Senft5/MOSSE/README.md

# MOSSE
A modular audio system for making and consuming audio content on the go.
The device functions like an iPod, with a capactive touch clickwheel, as well as a capactive touch slider for tweaking parameters.
Music files will be able to be uploaded over the usb-c port.
I made this project because I wanted something to take with me on the go that was highgly capable of all things audio. I want to be able to record, produce, and play back any audio that I can imagine, and this is the first step on that journey.


|No.|Quantity|Comment |Designator |Footprint |Value |Manufacturer Part |Manufacturer |Supplier Part|Supplier|LCSC Stock|LCSC Price|JLCPCB Stock|JLCPCB Price|Link |
|---|---|---|---|---|---|---|---|---|---|---|---|---|---|---|
|1  |1 |4.7uF |C1 |C0603 |4.7uF |TCC0603X7R475K160CT |CCTC(三环) |C48543608 |LCSC | | |9728 |0.0011 |https://www.lcsc.com/product-detail/C48543608.html|
|2  |3 |10uF |C2,C3,C7 |C0603 |10uF  |0603X106K100CT |Walsin(华新科) |C2840513 |LCSC | | |1835 |0.0022 |https://www.lcsc.com/product-detail/C2840513.html |
|3  |1 |100nF |C11 |C0603 |100nF |CC0603KRX7R9BB104 |YAGEO(国巨) |C14663 |LCSC | | |38654695 |0.0004 |https://www.lcsc.com/product-detail/C14663.html |
|4  |1 |1uF |C12 |C0603 |1uF |CL10A105KB8NNNC |SAMSUNG(三星) |C15849 |LCSC | | |8136262 |0.0012 |https://www.lcsc.com/product-detail/C15849.html |
|5  |2 |2.2uF |C13,C15 |C0603 |2.2uF |CL10A225KO8NNNC |SAMSUNG(三星) |C23630 |LCSC | | |4831225 |0.001 |https://www.lcsc.com/product-detail/C23630.html |
|6  |2 |4.7uF |C14,C16 |C0603 |4.7uF |V475K0603X5R160NDT |VIIYONG(微容) |C2980396 |LCSC | | |520 |0.0022 |https://www.lcsc.com/product-detail/C2980396.html |
|7  |2 |2.2uF |C17,C18 |C0603 |2.2uF |0603X225M160NT |FH(风华) |C50331154 |LCSC | | |10937 |0.001 |https://www.lcsc.com/product-detail/C50331154.html|
|8  |1 |1uF |C19 |C0603 |1uF |HCH0603B105K050T |IHHEC(禾伸堂) |C915830 |LCSC | | |3529 |0.0039 |https://www.lcsc.com/product-detail/C915830.html  |
|9  |3 |22uF |C20,C21,C22 |C0805 |22uF  |0805X226M160NT |FH(风华) |C129302 |LCSC | | |148576 |0.0043 |https://www.lcsc.com/product-detail/C129302.html  |
|10 |8 |10uF |C23,C24,C25,C26,C27,C28,C30,C33 |C0805 |10uF  |0805B106K160NT |FH(风华) |C92341 |LCSC | | |303267 |0.0043 |https://www.lcsc.com/product-detail/C92341.html |
|11 |1 |10pF |C29 |C0603 |10pF  |0603N100D500CT |Walsin(华新科) |C296044 |LCSC | | |8048 |0.0007 |https://www.lcsc.com/product-detail/C296044.html  |
|12 |4 |100nF |C31,C32,C34,C35 |C0603 |100nF |CL10B104KB8NNNC |SAMSUNG(三星) |C1591 |LCSC | | |8828921 |0.0005 |https://www.lcsc.com/product-detail/C1591.html |
|13 |1 |TF PUSH |CARD1 |TF-SMD_TF-PUSH | |TF PUSH |SHOU HAN(首韩) |C393941 |LCSC | | |148388 |0.0095 |https://www.lcsc.com/product-detail/C393941.html  |
|14 |1 |B3B-PH-K-S(LF)(SN) |CN1 |CONN-TH_B3B-PH-K-S | |B3B-PH-K-S(LF)(SN) |JST |C131339 |LCSC | | |186414 |0.0064 |https://www.lcsc.com/product-detail/C131339.html  |
|15 |1 |B2B-PH-K-S(LF)(SN) |CN2 |CONN-TH_B2B-PH-K-S | |B2B-PH-K-S(LF)(SN) |JST |C131337 |LCSC | | |229418 |0.0046 |https://www.lcsc.com/product-detail/C131337.html  |
|16 |1 |KH-FG0.5-H2.0-50PIN  |CN3 |FPC-SMD_KH-FG0.5-H2.0-50PIN | |KH-FG0.5-H2.0-50PIN |kinghelm(金航标)  |C2797221 |LCSC | | |1442 |0.0303 |https://www.lcsc.com/product-detail/C2797221.html |
|17 |1 |PJ-320D |CN4 |AUDIO-SMD_PJ-320D-1 | |PJ-320D |SHOU HAN(首韩) |C431535 |LCSC | | |96666 |0.0077 |https://www.lcsc.com/product-detail/C431535.html  |
|18 |1 |1N4148WS |D2 |SOD-323_L1.8-W1.3-LS2.5-RD | |1N4148WS |CJ(江苏长电/长晶) |C2128 |LCSC | | |4360704 |0.0014 |https://www.lcsc.com/product-detail/C2128.html |
|19 |1 |FH34SRJ-22S-0.5SH(50)|FPC1 |FFC-SMD_22P-P0.50_HRS_FH34SRJ-22S-0.5SH| |FH34SRJ-22S-0.5SH(50)  |HRS(广濑) |C2889325 |LCSC | | |8830 |0.0517 |https://www.lcsc.com/product-detail/C2889325.html |
|20 |1 |FH34SRJ-10S-0.5SH(50)|FPC2 |FFC-SMD_10P-P0.50_FH34SRJ-10S-0.5SH | |FH34SRJ-10S-0.5SH(50)  |HRS(广濑) |C324723 |LCSC | | |31597 |0.0324 |https://www.lcsc.com/product-detail/C324723.html  |
|21 |1 |1.5uH |L2 |IND-SMD_CYA1040-100UH |1.5uH |CYA1040-1.5UH |SHOU HAN(首韩) |C6364672 |LCSC | | |325 |0.05 |https://www.lcsc.com/product-detail/C6364672.html |
|22 |3 |MPZ1608S102ATA00 |L3,L4,L5 |L0603 | |MPZ1608S102ATA00 |TDK |C76814 |LCSC | | |279006 |0.002 |https://www.lcsc.com/product-detail/C76814.html |
|23 |1 |AO3400A |Q1 |SOT-23-3_L3.0-W1.6-P1.90-LS2.8-BR | |AO3400A |ElecSuper(静芯)  |C5224194 |LCSC | | |103382 |0.0036 |https://www.lcsc.com/product-detail/C5224194.html |
|24 |1 |1kΩ |R1 |R0603 |1kΩ |0603WAF1001T5E |UNI-ROYAL(厚声)  |C21190 |LCSC | | |44377889 |0.0003 |https://www.lcsc.com/product-detail/C21190.html |
|25 |1 |1.13kΩ |R2 |R0603 |1.13kΩ|0603WAF1131T5E |UNI-ROYAL(厚声)  |C22833 |LCSC | | |95366 |0.0002 |https://www.lcsc.com/product-detail/C22833.html |
|26 |1 |47kΩ |R3 |R0603 |47kΩ  |SCR0603J47K |VO(翔胜) |C3017699 |LCSC | | |2661 |0.0002 |https://www.lcsc.com/product-detail/C3017699.html |
|27 |1 |220kΩ |R10 |R0603 |220kΩ |0603WAF2203T5E |UNI-ROYAL(厚声)  |C22961 |LCSC | | |209466 |0.0003 |https://www.lcsc.com/product-detail/C22961.html |
|28 |1 |10kΩ |R11 |R0603 |10kΩ  |0603WAF1002T5E |UNI-ROYAL(厚声)  |C25804 |LCSC | | |19721756 |0.0002 |https://www.lcsc.com/product-detail/C25804.html |
|29 |1 |274kΩ |R12 |R0603 |274kΩ |RT0603BRE07274KL |YAGEO(国巨) |C705837 |LCSC | | |2189 |0.0041 |https://www.lcsc.com/product-detail/C705837.html  |
|30 |2 |100kΩ |R13,R15 |R0603 |100kΩ |FCR0603F100K |VO(翔胜) |C5913165 |LCSC | | |4019 |0.0003 |https://www.lcsc.com/product-detail/C5913165.html |
|31 |1 |270kΩ |R14 |R0603 |270kΩ |PTFR0603B270KN9 |RESI(开步睿思) |C19680171 |LCSC | | |4180 |0.0255 |https://www.lcsc.com/product-detail/C19680171.html|
|32 |6 |10kΩ |R16,R17,R18,R19,R20,R21 |R0603 |10kΩ  |SCR0603J10K |VO(翔胜) |C3017715 |LCSC | | |190 |0.0002 |https://www.lcsc.com/product-detail/C3017715.html |
|33 |2 |2.2kΩ |R22,R23 |R0402 |2.2kΩ |RMC04022.2K1%N |Tyohm(幸亚电阻) |C325418 |LCSC | | |3076 |0.0004 |https://www.lcsc.com/product-detail/C325418.html  |
|34 |11 |4.7kΩ |R24,R25,R26,R27,R28,R29,R30,R31,R32,R40,R41|R0603 |4.7kΩ |HoLTT0603-1/10W-4.7K-1%|Milliohm(毫欧) |C2904521 |LCSC | | |15483 |0.005 |https://www.lcsc.com/product-detail/C2904521.html |
|35 |2 |33Ω |R42,R46 |R0603 |33Ω |0603WAF330JT5E |UNI-ROYAL(厚声)  |C23140 |LCSC | | |2409800 |0.0003 |https://www.lcsc.com/product-detail/C23140.html |
|36 |2 |10Ω |R43,R48 |R0603 |10Ω |0603WAF100JT5E |UNI-ROYAL(厚声)  |C22859 |LCSC | | |1980594 |0.0003 |https://www.lcsc.com/product-detail/C22859.html |
|37 |4 |100kΩ |R44,R45,R47,R49 |R0603 |100kΩ |RC0603FR-07100KL |YAGEO(国巨) |C14675 |LCSC | | |1847372 |0.0003 |https://www.lcsc.com/product-detail/C14675.html |
|38 |1 |27Ω |R50 |R0805 |27Ω |CR0805F827R0G |LIZ(丽智电子) |C101623 |LCSC | | |6396 |0.0004 |https://www.lcsc.com/product-detail/C101623.html  |
|39 |1 |100kΩ |R51 |R0805 |100kΩ |SCR0805J100K |VO(翔胜) |C3017875 |LCSC | | |3193 |0.0002 |https://www.lcsc.com/product-detail/C3017875.html |
|40 |1 |33kΩ |R52 |R0805 |33kΩ  |RMC080533K1%N |Tyohm(幸亚电阻) |C269540 |LCSC | | |246 |0.0009 |https://www.lcsc.com/product-detail/C269540.html  |
|41 |1 |1.6MΩ |R53 |R0603 |1.6MΩ |FRC0603F1604TS |FOJAN(富捷) |C2999520 |LCSC | | |81819 |0.0002 |https://www.lcsc.com/product-detail/C2999520.html |
|42 |1 |180kΩ |R54 |R0603 |180kΩ |CR0603JA0184G |LIZ(丽智电子) |C101287 |LCSC | | |16 |0.0007 |https://www.lcsc.com/product-detail/C101287.html  |
|43 |1 |BQ24075RGTR |U1 |QFN-16_L3.0-W3.0-P0.50-TL-EP1.7 | |BQ24075RGTR |TI(德州仪器) |C15464 |LCSC | | |960 |0.153 |https://www.lcsc.com/product-detail/C15464.html |
|44 |1 |TPS63020DSJR |U2 |VSON-14_L4.0-W3.0-P0.50-BL-EP_TI_DSJ | |TPS63020DSJR |TI(德州仪器) |C15483 |LCSC | | |1640 |0.082 |https://www.lcsc.com/product-detail/C15483.html |
|45 |1 |Daisy_Seed |U4 |Daisy_Seed | | | | | |630 |1.4334 | | |https://electro-smith.com/products/daisy-seed |
|46 |1 |AP2112K-3.3TRG1(MS)  |U5 |SOT-23-5_L2.9-W1.6-P0.95-LS2.7-BR | |AP2112K-3.3TRG1(MS) |MSKSEMI(美森科) |C22365427 |LCSC | | |2427 |0.0111 |https://www.lcsc.com/product-detail/C22365427.html|
|47 |1 |LM27762DSSR |U6 |WSON-12_L3.0-W2.0-P0.50-BL-EP | |LM27762DSSR |TI(德州仪器) |C473398 |LCSC | | |14048 |0.1413 |https://www.lcsc.com/product-detail/C473398.html  |
|48 |3 |100nF |U7,U9,U11 |C0603 |100nF |C0603X104M5RACTU |KEMET(基美) |C23481007 |LCSC | | |0 | |https://www.lcsc.com/product-detail/C23481007.html|
|49 |1 |AT42QT2120-SUR |U8 |SOIC-20_L12.8-W7.5-P1.27-LS10.3-BL | |AT42QT2120-SUR |MICROCHIP(美国微芯)|C614938 |LCSC | | |170 |0.2779 |https://www.lcsc.com/product-detail/C614938.html  |
|50 |1 |DRV2605LDGSR |U10 |VSSOP-10_L3.0-W3.0-P0.50-LS4.9-BL | |DRV2605LDGSR |TI(德州仪器) |C527464 |LCSC | | |752 |0.21 |https://www.lcsc.com/product-detail/C527464.html  |
|51 |1 |Fusb302mpx |U12 |MLP-14_L2.5-W2.5-P0.50-BL-EP | |Fusb302mpx |onsemi(安森美) |C442699 |LCSC | | |5167 |0.1186 |https://www.lcsc.com/product-detail/C442699.html  |
|52 |2 |10uF |U14,U15 |CAP-SMD_BD4.0-L4.3-W4.3-LS5.0-FD |10uF  |RVT1C100M0405 10UF 16V |DMBJ(振宝佳) |C970654 |LCSC | | |10634 |0.0045 |https://www.lcsc.com/product-detail/C970654.html  |
|53 |1 |OPA1642AIDR |U16 |SOIC-8_L4.9-W3.9-P1.27-LS6.0-BL | |OPA1642AIDR |TI(德州仪器) |C67640 |LCSC | | |1616 |0.1996 |https://www.lcsc.com/product-detail/C67640.html |
|54 |1 |KH-TYPE-C-16P |USB1 |USB-C-SMD_KH-TYPE-C-16P | |KH-TYPE-C-16P |kinghelm(金航标)  |C709357 |LCSC | | |200632 |0.0112 |https://www.lcsc.com/product-detail/C709357.html  |
