Senft5/MOSSE/hardware/pcb/SCH_Schematic1_2026-03-25.pdf

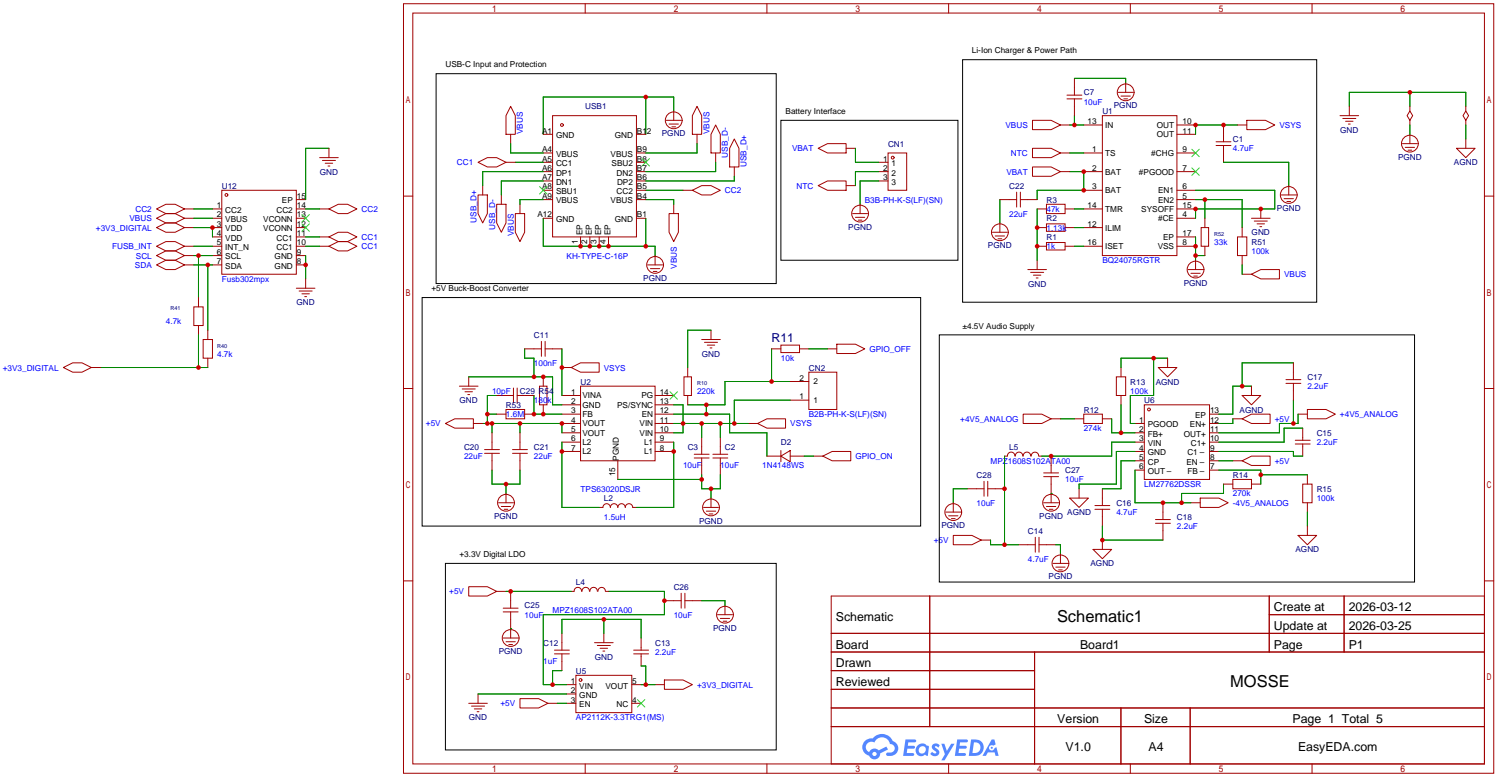
[picture p1: page 1]

Li-Ion Charger & Power Path

USB-C Input and Protection

VIN 10 VIN 11 EN 12 PS/SYNC 13 PG 14 PGND 15

Schematic | Schematic1 | Create at | 2026-03-12

Board | Board1 | Page | P1
Drawn | | MOSSE
Reviewed

Version | Size | Page 1 Total 5
V1.0 | A4 | EasyEDA.com

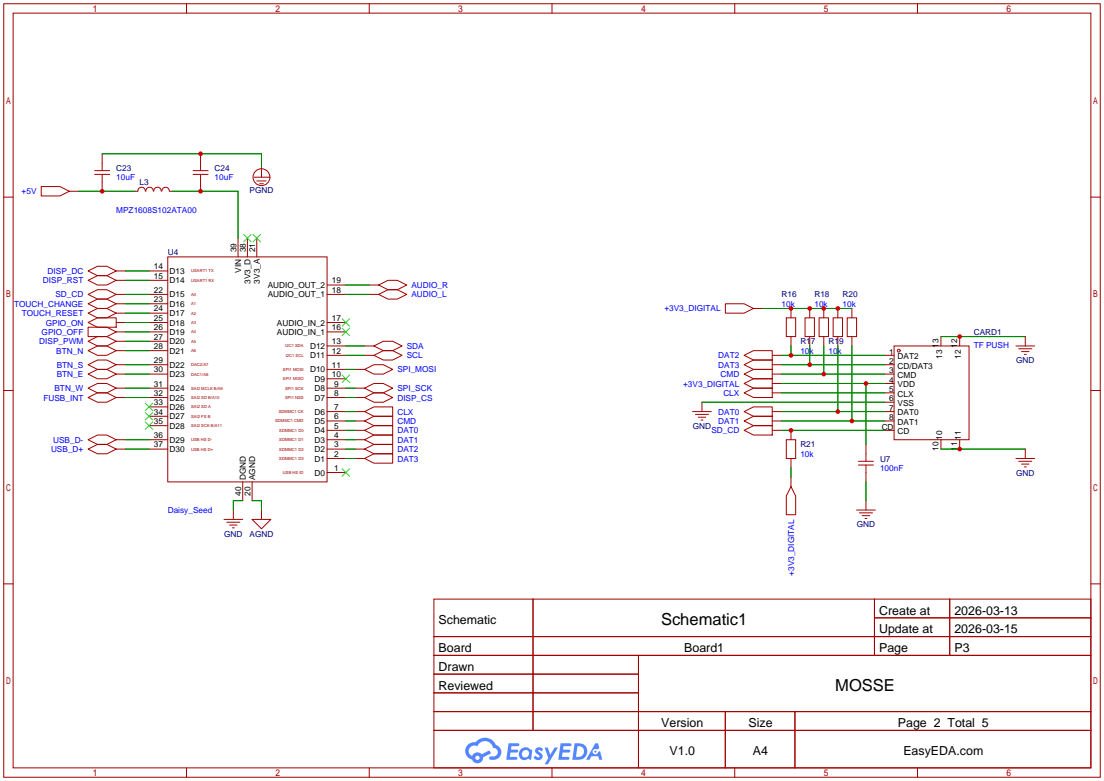
[picture p2: page 2]

Schematic | Schematic1 | Create at | 2026-03-13

Update at | 2026-03-15

Board | Board1 | Page | P3
Drawn | | MOSSE
Reviewed

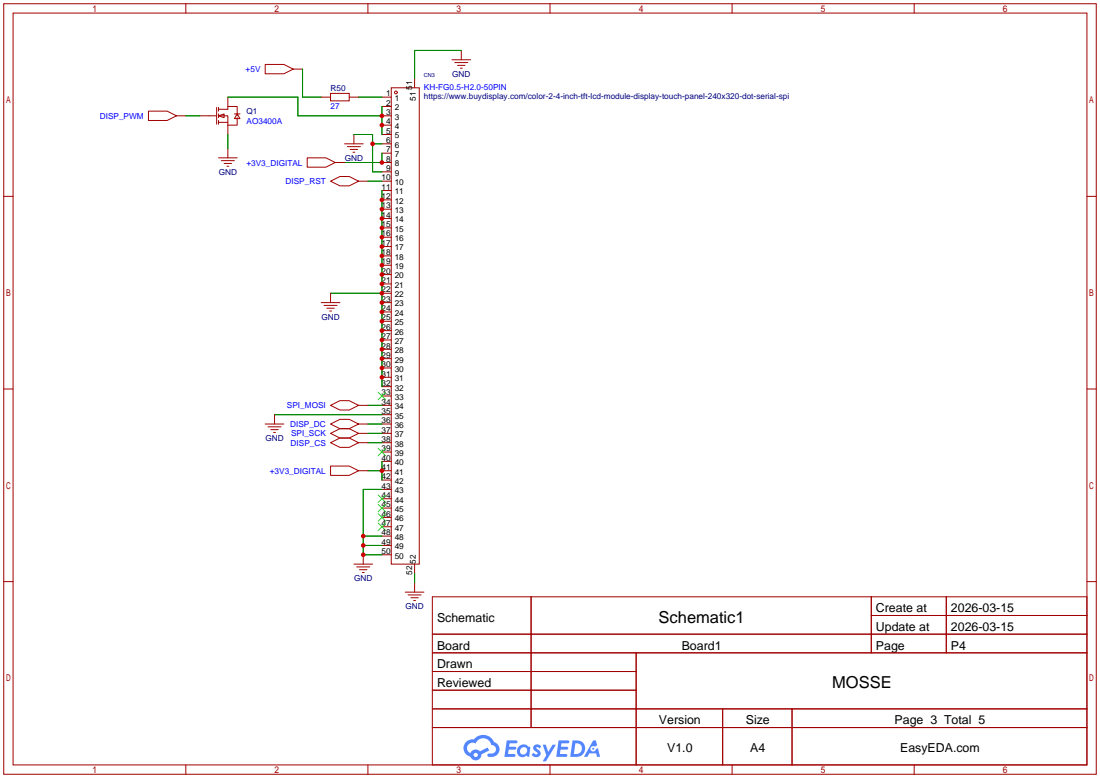
[picture p3: page 3]

Schematic | Schematic1 | Create at | 2026-03-15

Update at | 2026-03-15

Board | Board1 | Page | P4
Drawn | | MOSSE
Reviewed

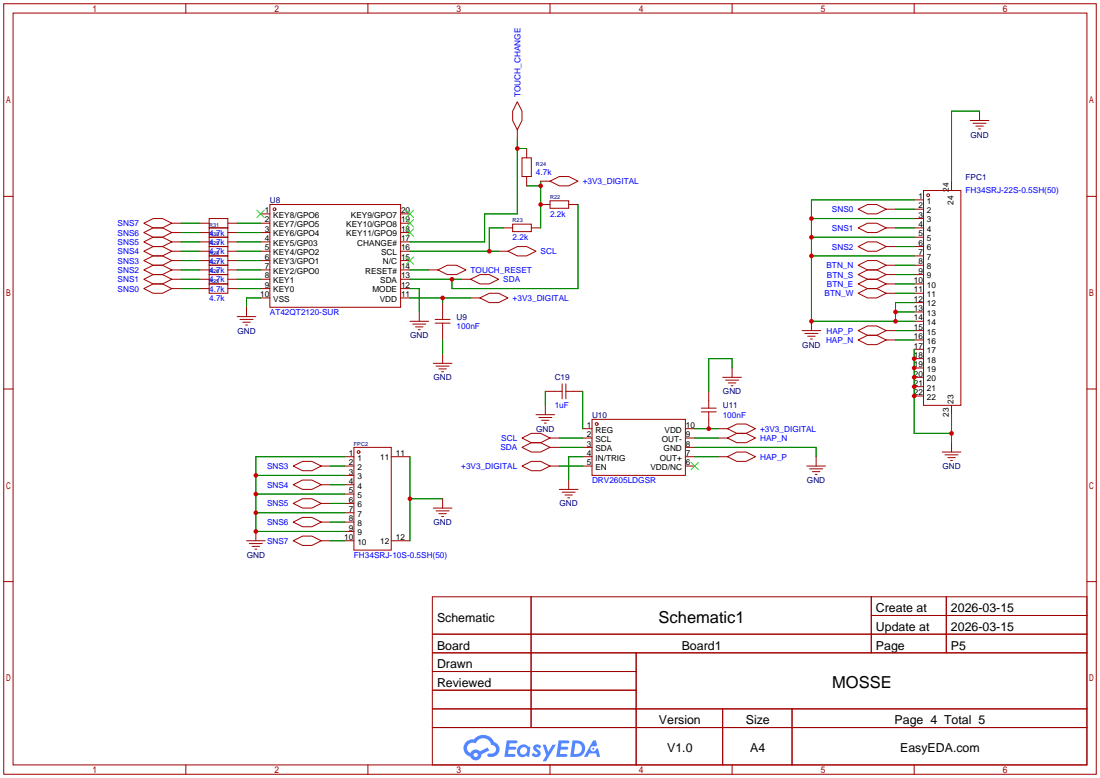
[picture p4: page 4]

Schematic | Schematic1 | Create at | 2026-03-15

Update at | 2026-03-15

Board | Board1 | Page | P5
Drawn | | MOSSE
Reviewed

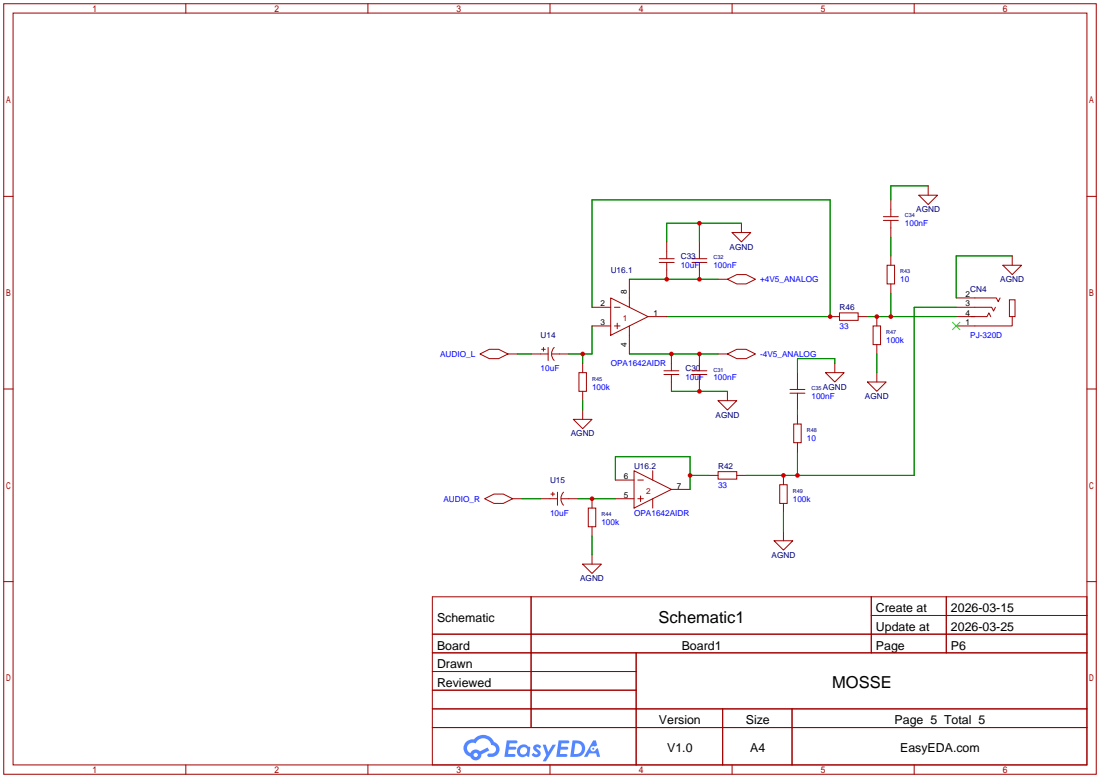
[picture p5: page 5]

Schematic | Schematic1 | Create at | 2026-03-15

Update at | 2026-03-25

Board | Board1 | Page | P6
Drawn | | MOSSE
Reviewed
