Senft5/MOSSE/(list of files, drawings)

Other design files:
hardware/pcb/ProPrj_MOSSE_2026-03-25.epro
