Senft5/MOSSE/(commit log)

2026-03-26 Add test file for PCB hardware
2026-03-26 README with device features and purpose
    Added details about device functionality and project motivation.
